ajax98/permamote/hardware/permamote/rev_b/permamote.brd

## EAGLE design hardware/permamote/rev_b/permamote.brd (2017-11-19)

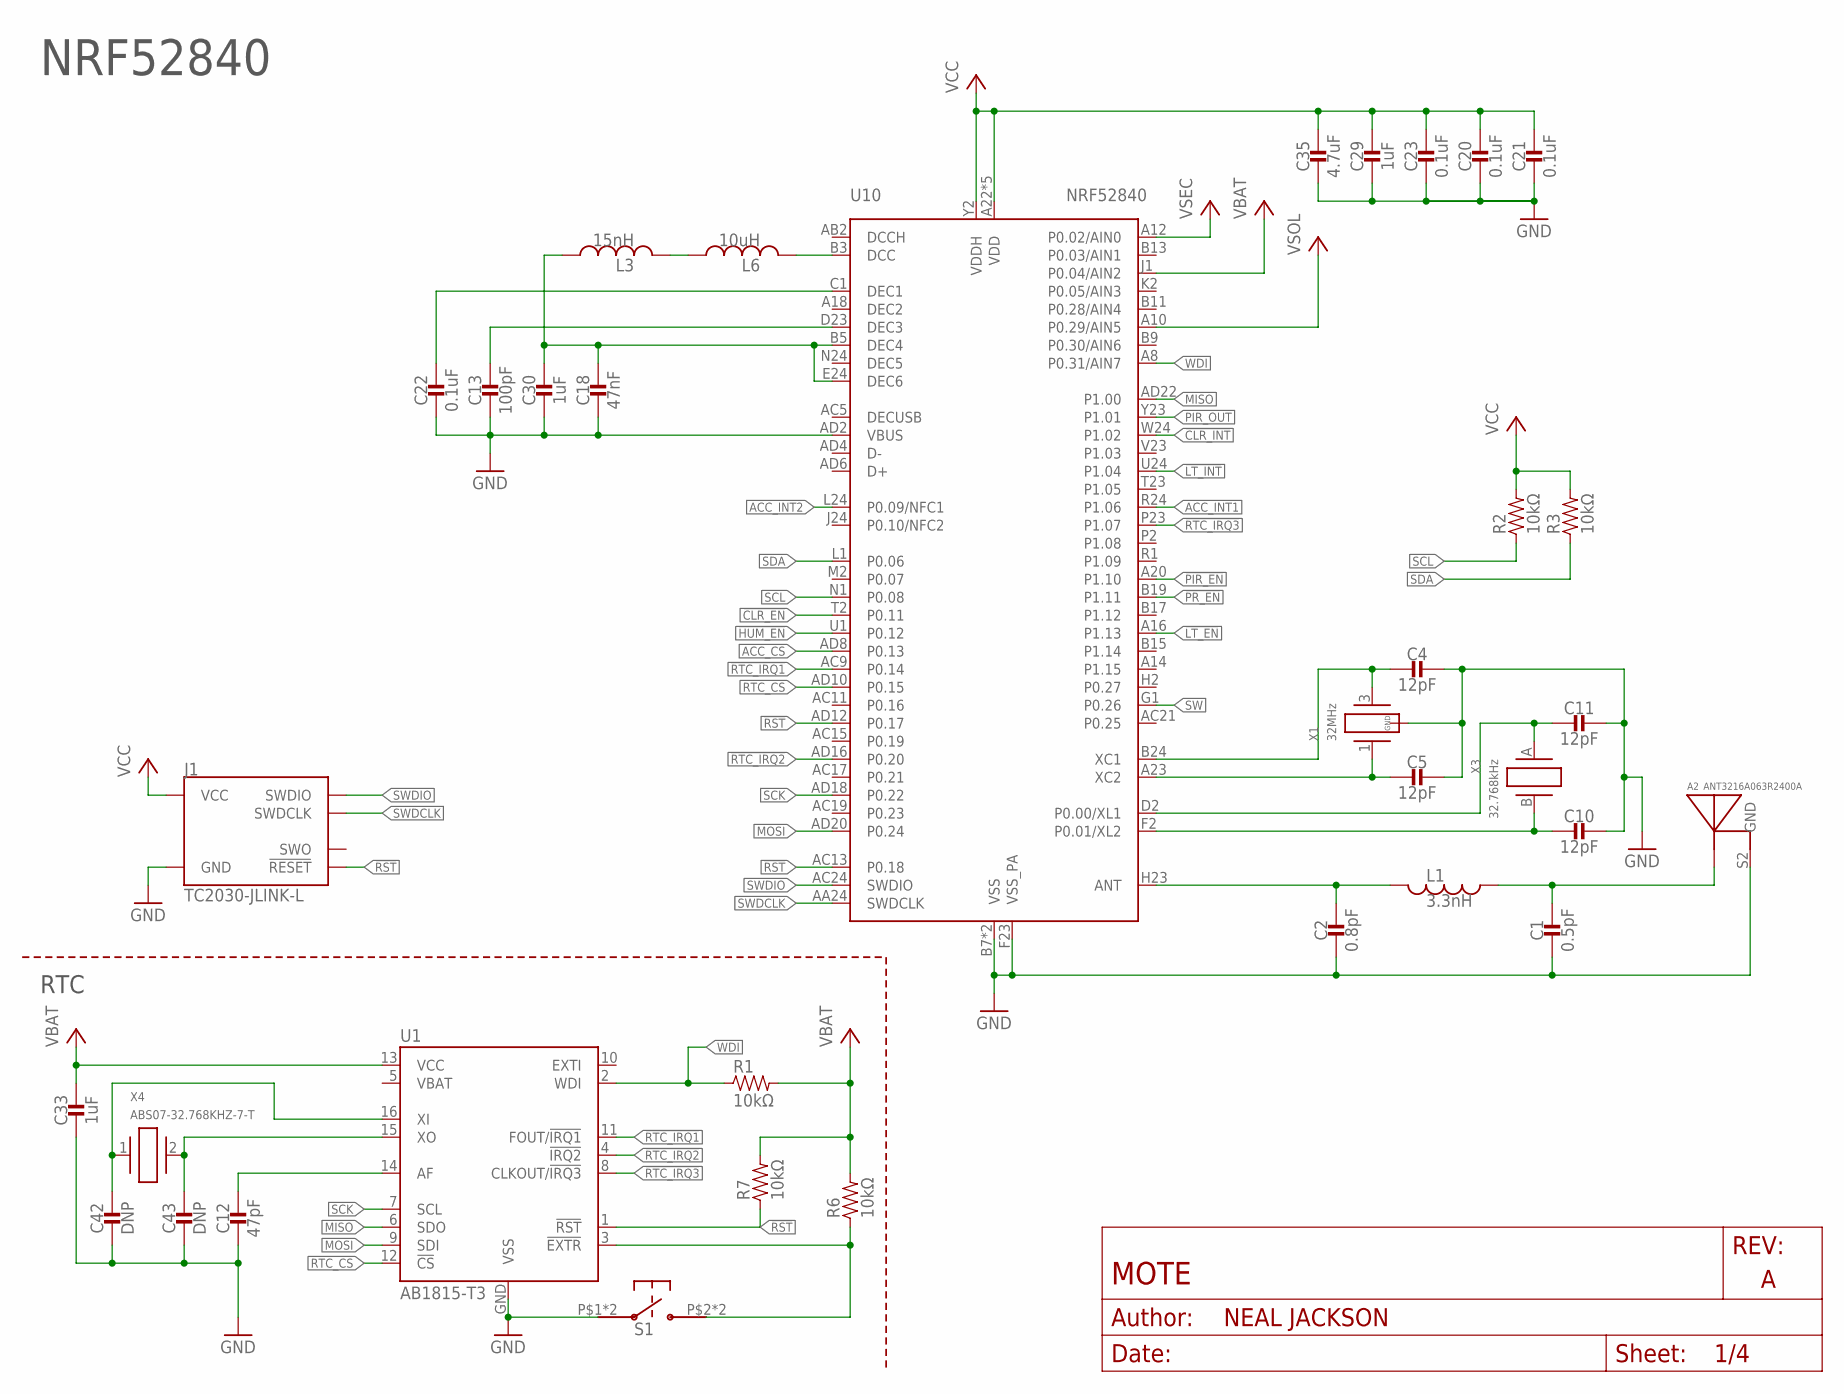
[picture p1: schematic permamote.sch, sheet 1]

Parts:
A2: ANT3216A063R2400A
C1: 0.5pF; 0402_CAP; DIGIKEY 490-6264-1-ND
C2: 0.8pF; 0402_CAP; DIGIKEY 490-6269-1-ND
C4, C5, C10, C11: 12pF; 0402_CAP; DIGIKEY 490-6197-1-ND
C12: 47pF; 0402_CAP; DIGIKEY 490-5942-1-ND
C13: 100pF; 0402_CAP; DIGIKEY 490-5922-1-ND
C18: 47nF; 0402_CAP; DIGIKEY 445-1264-1-ND
C20, C21, C22, C23: 0.1uF; 0402_CAP; DIGIKEY 490-6328-1-ND
C29, C30, C33: 1uF; 0402_CAP; DIGIKEY 490-7195-1-ND
C35: 4.7uF; 0402_CAP; DIGIKEY 445-5947-1-ND
C42, C43: DNP; 0402_CAP
J1: TC2030-JLINK-L; TC2030-IDC
L1: 3.3nH; 0402_CAP; DIGIKEY 535-10426-1-ND
L3: 15nH; 0402_CAP; DIGIKEY 587-1521-1-ND
L6: 10uH; 0603_CAP; DIGIKEY 490-4025-1-ND
R1, R2, R3, R6, R7: 10kΩ; 0402_RES; DIGIKEY 311-10KJRCT-ND
S1: EVQP2
U1: AB1815-T3; QFN-16-3MM
U10: NRF52840; AQFN73
X1: 32MHz; TXC-7V
X3: 32.768kHz; ABS05
X4: ABS07-32.768KHZ-7-T; 2-SMD

Connections:
!CLR_EN: U10.T2 (P0.11); also elsewhere on the board
!CLR_INT: U10.W24 (P1.02); also elsewhere on the board
!HUM_EN: U10.U1 (P0.12); also elsewhere on the board
!LT_EN: U10.A16 (P1.13); also elsewhere on the board
!LT_INT: U10.U24 (P1.04); also elsewhere on the board
!PIR_EN: U10.A20 (P1.10); also elsewhere on the board
!PR_EN: U10.B19 (P1.11); also elsewhere on the board
!RST: J1.3 (!RESET), R7.1, U1.1 (!RST), U10.AC13 (P0.18), U10.AD12 (P0.17); also elsewhere on the board
!RTC_EXTR: R6.1, S1.P$2, S1.P$4, U1.3 (!EXTR)
!RTC_IRQ1: U1.11 (FOUT/!IRQ1), U10.AC9 (P0.14); also elsewhere on the board
!RTC_IRQ2: U1.4 (!IRQ2), U10.AD16 (P0.20); also elsewhere on the board
!RTC_IRQ3: U1.8 (CLKOUT/!IRQ3), U10.P23 (P1.07); also elsewhere on the board
ACC_CS: U10.AD8 (P0.13); also elsewhere on the board
ACC_INT1: U10.R24 (P1.06); also elsewhere on the board
ACC_INT2: U10.L24 (P0.09/NFC1); also elsewhere on the board
GND: A2.S2 (GND), C1.2, C2.2, C4.1, C5.1, C10.1, C11.1, C12.2, C13.2, C18.2, C20.2, C21.2, C22.2, C23.2, C29.2, C30.2, C33.2, C35.2, C42.2, C43.2, J1.5 (GND), S1.P$1, S1.P$3, U1.GND (VSS), U10.AD2 (VBUS), U10.B7 (VSS), U10.F23 (VSS_PA), U10.GND (VSS), X1.2 (GND), X1.4 (GND); also elsewhere on the board
MISO: U1.6 (SDO), U10.AD22 (P1.00); also elsewhere on the board
MOSI: U1.9 (SDI), U10.AD20 (P0.24); also elsewhere on the board
unnamed: C22.1, U10.C1 (DEC1)
unnamed: C18.1, C30.1, L3.1, U10.B5 (DEC4), U10.E24 (DEC6)
unnamed: C13.1, U10.D23 (DEC3)
unnamed: C2.1, L1.2, U10.H23 (ANT)
unnamed: A2.S1 (ANTENNA), C1.1, L1.1
unnamed: C4.2, U10.B24 (XC1), X1.3 (2)
unnamed: C5.2, U10.A23 (XC2), X1.1
unnamed: C12.1, U1.14 (AF)
unnamed: C42.1, U1.16 (XI), X4.1
unnamed: C43.1, U1.15 (XO), X4.2
unnamed: L6.2, U10.B3 (DCC)
unnamed: L3.2, L6.1
PIR_OUT: U10.Y23 (P1.01); also elsewhere on the board
RTC_CS: U1.12 (!CS), U10.AD10 (P0.15); also elsewhere on the board
SCK: U1.7 (SCL), U10.AD18 (P0.22); also elsewhere on the board
SCL: R2.1, U10.N1 (P0.08); also elsewhere on the board
SDA: R3.1, U10.L1 (P0.06); also elsewhere on the board
SW: U10.G1 (P0.26); also elsewhere on the board
SWDCLK: J1.4 (SWDCLK), U10.AA24 (SWDCLK)
SWDIO: J1.2 (SWDIO), U10.AC24 (SWDIO)
VBAT: C33.1, R1.2, R6.2, R7.2, U1.13 (VCC), U10.J1 (P0.04/AIN2); also elsewhere on the board
VCC: C20.1, C21.1, C23.1, C29.1, C35.1, J1.1 (VCC), R2.2, R3.2, U10.A22 (VDD), U10.AD14 (VDD), U10.AD23 (VDD), U10.B1 (VDD), U10.W1 (VDD), U10.Y2 (VDDH); also elsewhere on the board
VSEC: U10.A12 (P0.02/AIN0); also elsewhere on the board
VSOL: U10.A10 (P0.29/AIN5); also elsewhere on the board
WDI: R1.1, U1.2 (WDI), U10.A8 (P0.31/AIN7); also elsewhere on the board
XL1: C11.2, U10.D2 (P0.00/XL1), X3.A (1)
XL2: C10.2, U10.F2 (P0.01/XL2), X3.B (2)

Notes on the sheet:
NRF52840
RTC

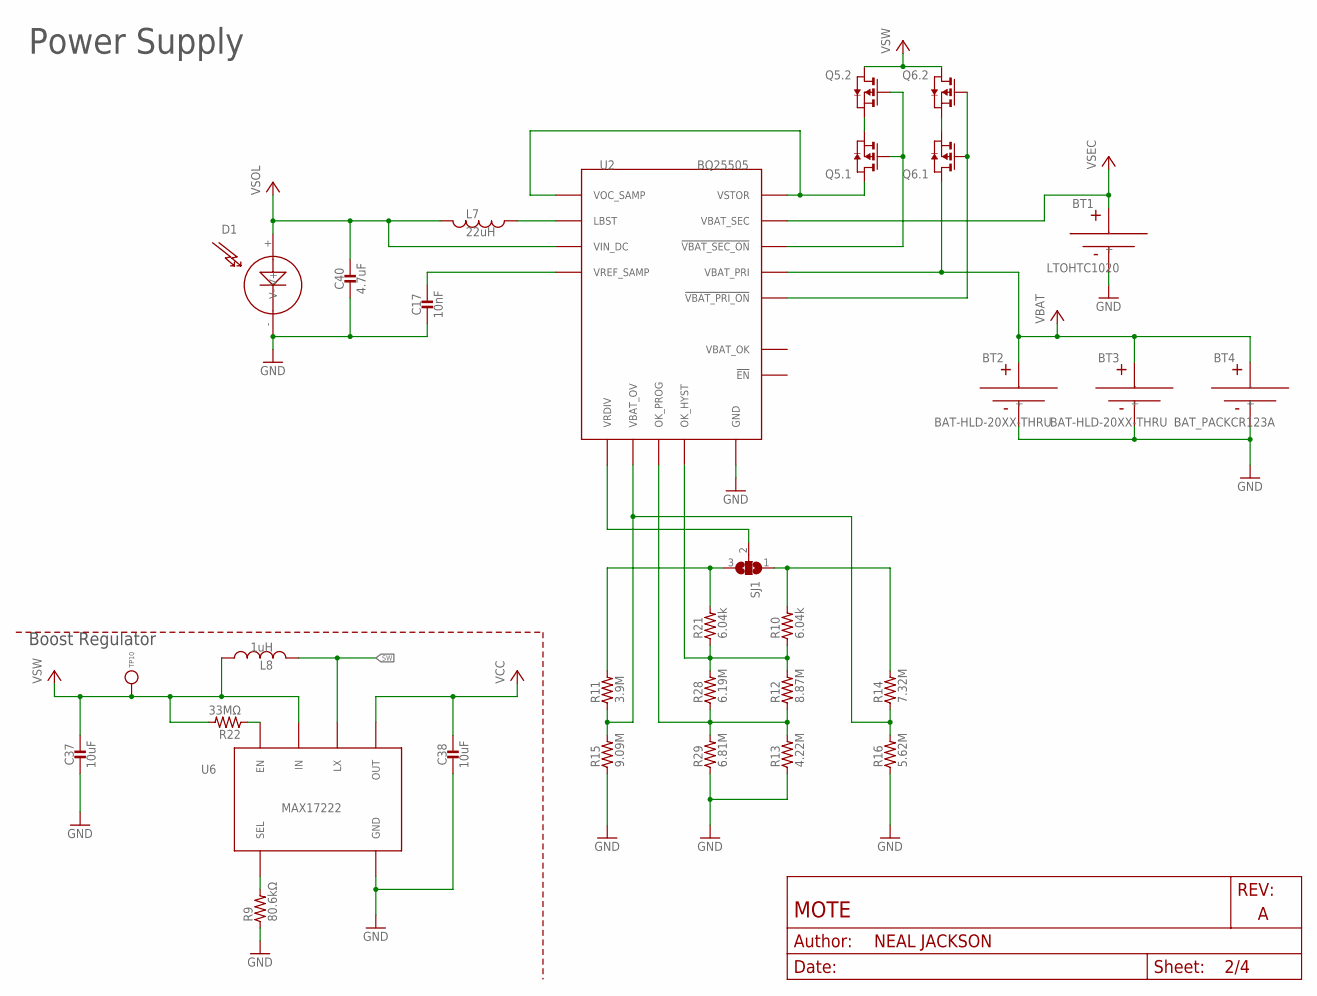
[picture p2: schematic permamote.sch, sheet 2]

Parts:
BT1: LTOHTC1020; 1020
BT2, BT3: BAT-HLD-20XX-THRU
BT4: BAT_PACKCR123A; BH123A
C17: 10nF; 0603_CAP; DIGIKEY 490-4516-1-ND
C37, C38: 10uF; 0603_CAP; DIGIKEY 490-3896-1-ND
C40: 4.7uF; 0603_CAP; DIGIKEY 490-3896-1-ND
D1: SOLARCELL; SOLAR_HOLES
L7: 22uH; 74437324220; DIGIKEY 732-3340-1-ND
L8: 1uH; IHL-1212BZ-11; MPN IHLP1212BZER1R0M11; DIGIKEY 541-1319-1-ND
Q5, Q6: PMDXB950UPEL; XDFN-6
R9: 80.6kΩ; 0603-RES; DIGIKEY 311-80.6KHRCT-ND
R10, R21: 6.04k; 0402_RES; DIGIKEY YAG3306CT-ND
R11: 3.9M; 0402_RES; DIGIKEY YAG3306CT-ND
R12: 8.87M; 0402_RES; DIGIKEY YAG3306CT-ND
R13: 4.22M; 0402_RES; DIGIKEY YAG3306CT-ND
R14: 7.32M; 0402_RES; DIGIKEY YAG3306CT-ND
R15: 9.09M; 0402_RES; DIGIKEY YAG3306CT-ND
R16: 5.62M; 0402_RES; DIGIKEY YAG3306CT-ND
R22: 33MΩ; 0603-RES; DIGIKEY HMC0603JT33M0CT-ND
R28: 6.19M; 0402_RES; DIGIKEY YAG3306CT-ND
R29: 6.81M; 0402_RES; DIGIKEY YAG3306CT-ND
SJ1: SJ2W; SJ_2
TP10: TEST_POINT_0.040IN; TESTPOINT_0.040IN
U2: BQ25505; S-PVQFN-N20-RGR
U6: MAX17222; UDFN-6-MAXIM

Connections:
GND: BT1.-, BT2.GND (-), BT3.GND (-), BT4.-, C17.2, C37.2, C38.2, C40.2, D1.- (V-), R9.1, R13.1, R15.1, R16.1, R29.1, U2.1 (GND), U2.6 (GND), U2.15 (GND), U2.16 (GND), U2.17 (GND), U2.PAD (GND), U6.3 (GND); also elsewhere on the board
unnamed: R11.2, R21.2, SJ1.3
unnamed: R9.2, U6.4 (SEL)
unnamed: R22.1, U6.6 (EN)
unnamed: R10.2, R14.2, SJ1.1
unnamed: R11.1, R14.1, R15.2, R16.2, U2.7 (VBAT_OV)
unnamed: C17.1, U2.4 (VREF_SAMP)
unnamed: SJ1.2, U2.8 (VRDIV)
unnamed: L7.P$1 (1), U2.20 (LBST)
unnamed: Q5.1 (S), Q5.4 (S)
unnamed: Q5.2 (G), Q5.5 (G), U2.9 (!VBAT_SEC_ON)
unnamed: Q5.6 (D), U2.3 (VOC_SAMP), U2.19 (VSTOR)
unnamed: Q6.1 (S), Q6.4 (S)
unnamed: Q6.2 (G), Q6.5 (G), U2.10 (!VBAT_PRI_ON)
unnamed: R12.1, R13.2, R28.1, R29.2, U2.12 (OK_PROG)
unnamed: R10.1, R12.2, R21.1, R28.2, U2.11 (OK_HYST)
SW: L8.P$2 (2), U6.2 (LX); also elsewhere on the board
VBAT: BT2.+1 (+), BT2.+2 (+), BT2.+3 (+), BT2.+4 (+), BT3.+1 (+), BT3.+2 (+), BT3.+3 (+), BT3.+4 (+), BT4.+, Q6.6 (D), U2.14 (VBAT_PRI); also elsewhere on the board
VCC: C38.1, U6.1 (OUT); also elsewhere on the board
VSEC: BT1.+, U2.18 (VBAT_SEC); also elsewhere on the board
VSOL: C40.1, D1.+ (V+), L7.P$2 (2), U2.2 (VIN_DC); also elsewhere on the board
VSW: C37.1, L8.P$1 (1), Q5.3 (D), Q6.3 (D), R22.2, TP10.TESTPOINT, U6.5 (IN)

Notes on the sheet:
Power Supply
Boost Regulator

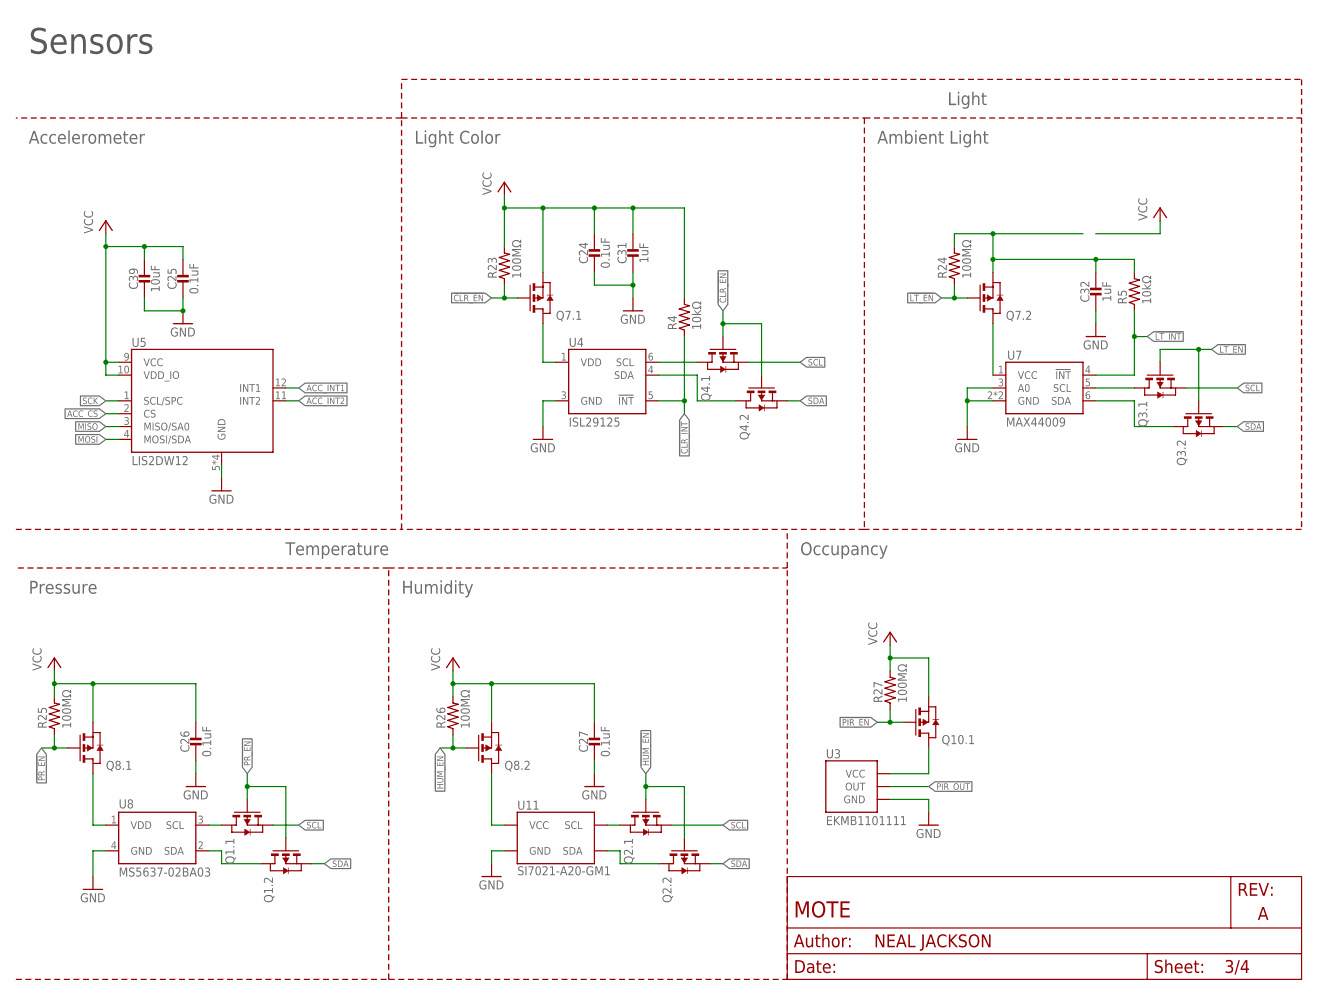
[picture p3: schematic permamote.sch, sheet 3]

Parts:
C24, C25, C26, C27: 0.1uF; 0402_CAP; DIGIKEY 490-6328-1-ND
C31, C32: 1uF; 0402_CAP; DIGIKEY 490-7195-1-ND
C39: 10uF; 0603_CAP; DIGIKEY 490-3896-1-ND
Q1, Q2, Q3, Q4, Q7, Q8, Q10: PMDXB950UPEL; XDFN-6
R4, R5: 10kΩ; 0402_RES; DIGIKEY 311-10KJRCT-ND
R23, R24, R25, R26, R27: 100MΩ; 0402_RES; DIGIKEY 541-100MAHCT-ND
U3: EKMB1101111; AMN2
U4: ISL29125; ODFN-6-1.5MMX1.6MM
U5: LIS2DW12; LGA-12
U7: MAX44009; UDFN-6-EXPOSED
U8: MS5637-02BA03; 4-SMD
U11: SI7021-A20-GM1; DFN-6/3MM

Connections:
!CLR_EN: Q4.2 (G), Q4.5 (G), Q7.2 (G), R23.1; also elsewhere on the board
!CLR_INT: R4.1, U4.5 (!INT); also elsewhere on the board
!HUM_EN: Q2.2 (G), Q2.5 (G), Q8.5 (G), R26.1; also elsewhere on the board
!LT_EN: Q3.2 (G), Q3.5 (G), Q7.5 (G), R24.1; also elsewhere on the board
!LT_INT: R5.1, U7.4 (!INT); also elsewhere on the board
!PIR_EN: Q10.2 (G), R27.1; also elsewhere on the board
!PR_EN: Q1.2 (G), Q1.5 (G), Q8.2 (G), R25.1; also elsewhere on the board
ACC_CS: U5.2 (CS); also elsewhere on the board
ACC_INT1: U5.12 (INT1); also elsewhere on the board
ACC_INT2: U5.11 (INT2); also elsewhere on the board
GND: C24.2, C25.2, C26.2, C27.2, C31.2, C32.2, C39.2, U3.GND, U4.3 (GND), U5.5 (GND), U5.6 (GND), U5.7 (GND), U5.8 (GND), U7.2 (GND), U7.3 (A0), U7.EP (GND), U8.4 (GND), U11.2 (GND); also elsewhere on the board
MISO: U5.3 (MISO/SA0); also elsewhere on the board
MOSI: U5.4 (MOSI/SDA); also elsewhere on the board
unnamed: Q7.3 (D), U7.1 (VCC)
unnamed: Q8.6 (D), U8.1 (VDD)
unnamed: Q8.3 (D), U11.5 (VCC)
unnamed: Q10.6 (D), U3.VCC
unnamed: Q7.6 (D), U4.1 (VDD)
unnamed: Q1.6 (D), U8.3 (SCL)
unnamed: C32.1, Q7.4 (S), R5.2, R24.2
unnamed: Q1.3 (D), U8.2 (SDA)
unnamed: Q2.3 (D), U11.1 (SDA)
unnamed: Q2.6 (D), U11.6 (SCL)
unnamed: Q3.3 (D), U7.6 (SDA)
unnamed: Q3.6 (D), U7.5 (SCL)
unnamed: Q4.3 (D), U4.4 (SDA)
unnamed: Q4.6 (D), U4.6 (SCL)
PIR_OUT: U3.OUT; also elsewhere on the board
SCK: U5.1 (SCL/SPC); also elsewhere on the board
SCL: Q1.1 (S), Q2.1 (S), Q3.1 (S), Q4.1 (S); also elsewhere on the board
SDA: Q1.4 (S), Q2.4 (S), Q3.4 (S), Q4.4 (S); also elsewhere on the board
VCC: C24.1, C25.1, C26.1, C27.1, C31.1, C39.1, Q7.1 (S), Q8.1 (S), Q8.4 (S), Q10.1 (S), R4.2, R23.2, R25.2, R26.2, R27.2, U5.9 (VCC), U5.10 (VDD_IO); also elsewhere on the board

Notes on the sheet:
Sensors
Accelerometer
Temperature
Humidity
Pressure
Ambient Light
Light Color
Light
Occupancy

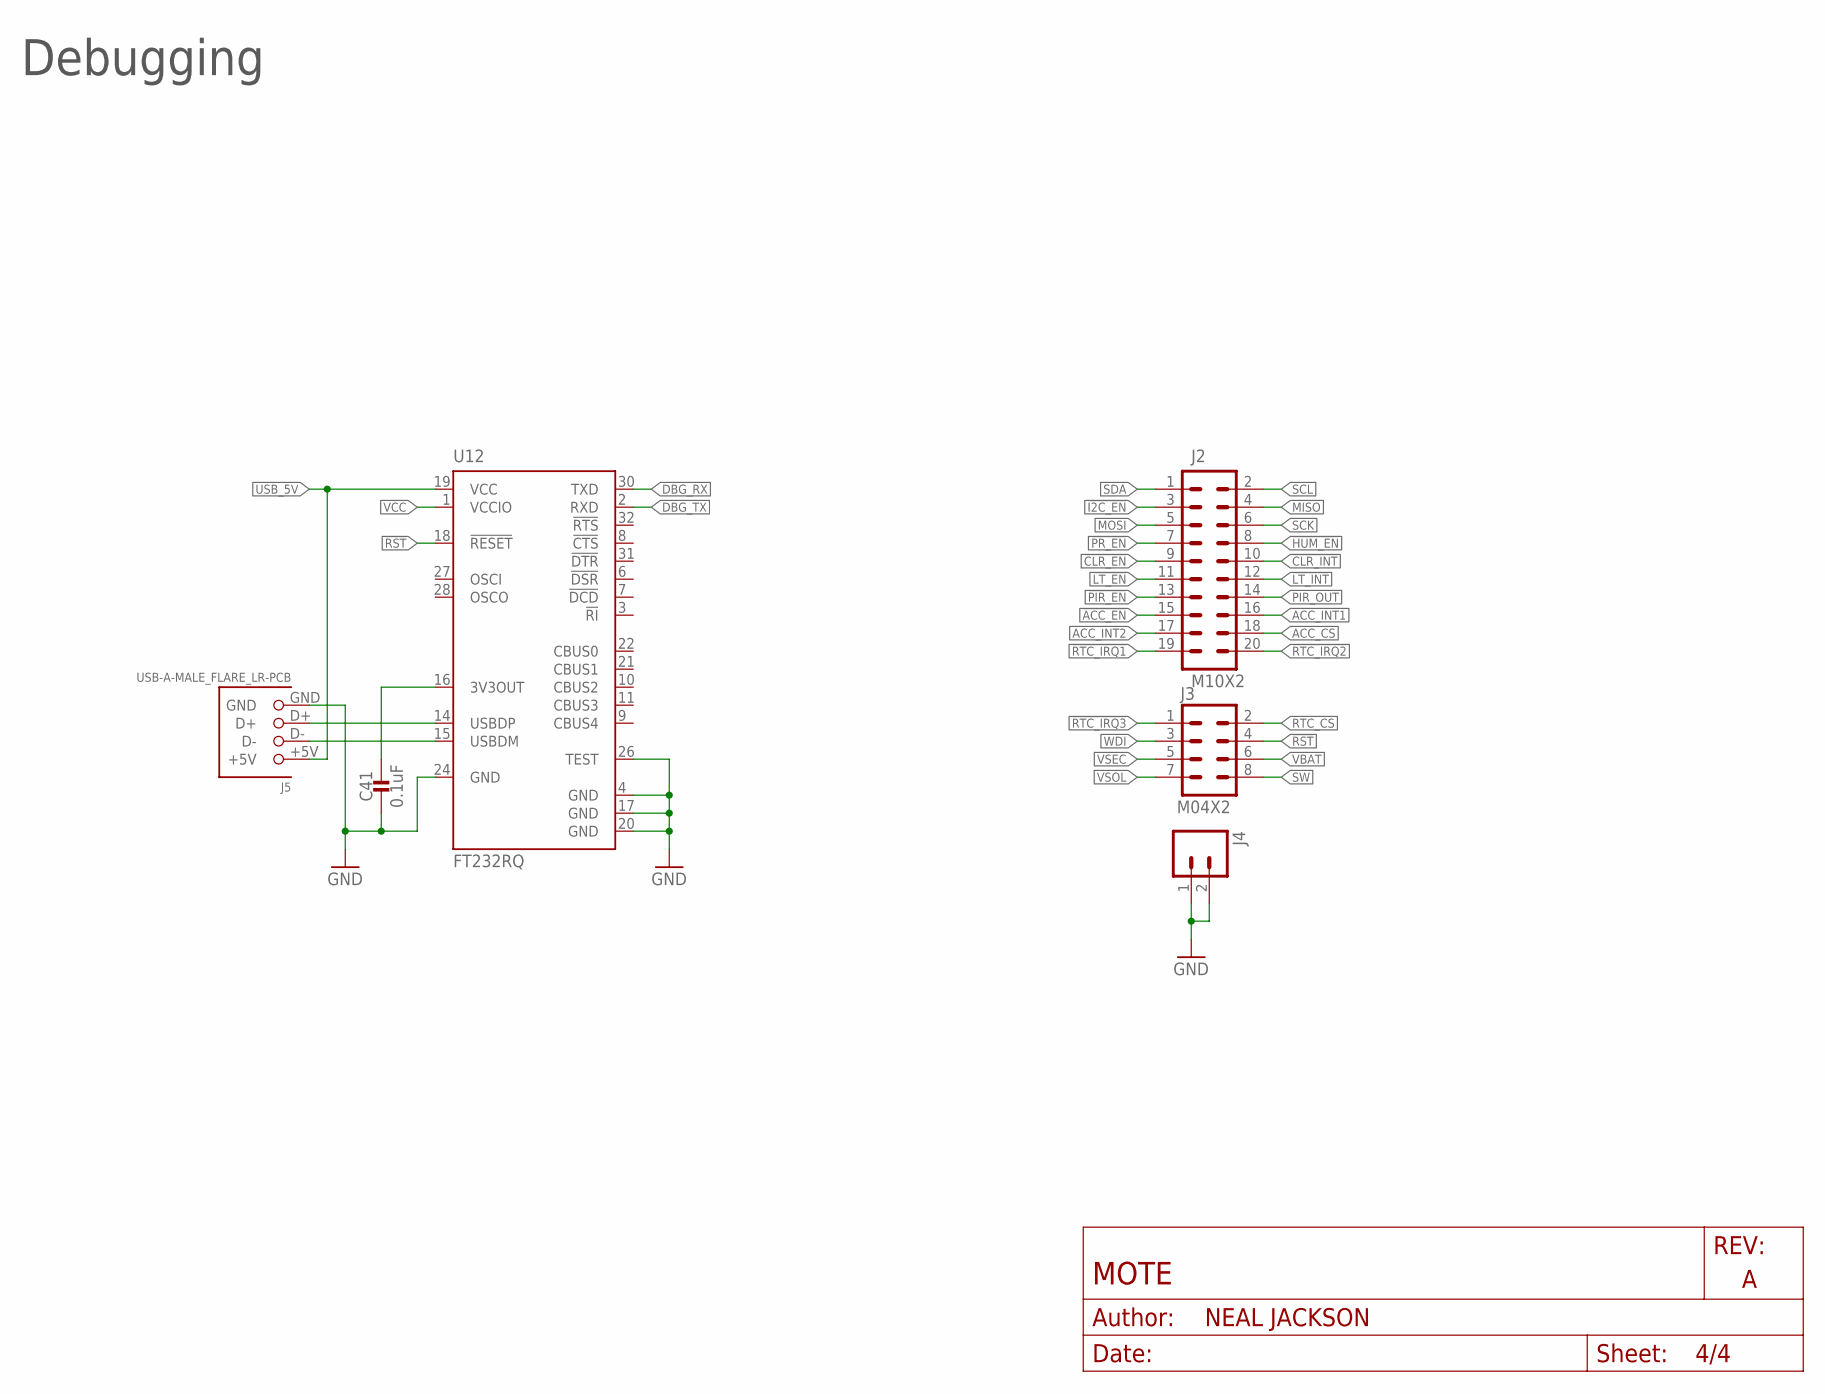
[picture p4: schematic permamote.sch, sheet 4]

Parts:
C41: 0.1uF; 0402_CAP; DIGIKEY 490-6328-1-ND
J2: M10X2; 2X10
J3: M04X2; 2X4
J4: M02PTH; 1X02
J5: USB-A-MALE_FLARE_LR-PCB; USB-A-MALE_FLARE_LR
U12: FT232RQ; QFN32

Connections:
!ACC_EN: J2.15
!CLR_EN: J2.9; also elsewhere on the board
!CLR_INT: J2.10; also elsewhere on the board
!HUM_EN: J2.8; also elsewhere on the board
!I2C_EN: J2.3
!LT_EN: J2.11; also elsewhere on the board
!LT_INT: J2.12; also elsewhere on the board
!PIR_EN: J2.13; also elsewhere on the board
!PR_EN: J2.7; also elsewhere on the board
!RST: J3.4, U12.18 (!RESET); also elsewhere on the board
!RTC_IRQ1: J2.19; also elsewhere on the board
!RTC_IRQ2: J2.20; also elsewhere on the board
!RTC_IRQ3: J3.1; also elsewhere on the board
ACC_CS: J2.18; also elsewhere on the board
ACC_INT1: J2.16; also elsewhere on the board
ACC_INT2: J2.17; also elsewhere on the board
DBG_RX: U12.30 (TXD)
DBG_TX: U12.2 (RXD)
GND: C41.2, J4.1, J4.2, J5.GND, U12.4 (GND), U12.17 (GND), U12.20 (GND), U12.24 (GND), U12.26 (TEST); also elsewhere on the board
MISO: J2.4; also elsewhere on the board
MOSI: J2.5; also elsewhere on the board
unnamed: C41.1, U12.16 (3V3OUT)
PIR_OUT: J2.14; also elsewhere on the board
RTC_CS: J3.2; also elsewhere on the board
SCK: J2.6; also elsewhere on the board
SCL: J2.2; also elsewhere on the board
SDA: J2.1; also elsewhere on the board
SW: J3.8; also elsewhere on the board
USB_5V: J5.+5V, U12.19 (VCC)
USB_D+: J5.D+, U12.14 (USBDP)
USB_D-: J5.D-, U12.15 (USBDM)
VBAT: J3.6; also elsewhere on the board
VCC: U12.1 (VCCIO); also elsewhere on the board
VSEC: J3.5; also elsewhere on the board
VSOL: J3.7; also elsewhere on the board
WDI: J3.3; also elsewhere on the board

Notes on the sheet:
Debugging

Board: 4 copper layers, 98 parts (0 on the bottom side), 79 nets, no tracks yet.

Other parts of the board:
U$1: UCB_CAL_200MIL
