ajax98/permamote/software/include/permamote.h

#ifndef PERMAMOTE_H
#define PERMAMOTE_H

#ifndef DEVICE_NAME
#define DEVICE_NAME "PERMAMOTE"
#endif /*DEVICE_NAME*/

#include <stdint.h>

//#define PLATFORM_ID_BYTE 0x22

// Address is written here in flash if the ID command is used
//#define ADDRESS_FLASH_LOCATION 0x0003fff8

// DEFINES FOR NRF52840
#ifdef NRF52840

// I2C through headers
#define I2C_SCL     NRF_GPIO_PIN_MAP(0,8)
#define I2C_SDA     NRF_GPIO_PIN_MAP(0,6)

// SPI through headers
#define SPI_SCLK    NRF_GPIO_PIN_MAP(0,22)
#define SPI_MISO    NRF_GPIO_PIN_MAP(1,0)
#define SPI_MOSI    NRF_GPIO_PIN_MAP(0,24)

// Light Sensor
#define MAX44009_EN  NRF_GPIO_PIN_MAP(1,13)
#define MAX44009_INT NRF_GPIO_PIN_MAP(1,4)

// Color Sensor
#define ISL29125_EN  NRF_GPIO_PIN_MAP(0,11)
#define ISL29125_INT NRF_GPIO_PIN_MAP(1,2)

// Pressure sensor
#define MS5637_EN   NRF_GPIO_PIN_MAP(1,11)

//Humidity Sensor
#define SI7021_EN   NRF_GPIO_PIN_MAP(0,12)

// Accelerometer
#define LI2D_CS     NRF_GPIO_PIN_MAP(0,13)
#define LI2D_INT1   NRF_GPIO_PIN_MAP(1,6)
#define LI2D_INT2   NRF_GPIO_PIN_MAP(0,9)

//PIR
#define PIR_EN      NRF_GPIO_PIN_MAP(1,10)
#define PIR_OUT     NRF_GPIO_PIN_MAP(1,1)

//RTC
#define RTC_CS      NRF_GPIO_PIN_MAP(0,15)
#define RTC_INT1    NRF_GPIO_PIN_MAP(0,14)
#define RTC_INT2    NRF_GPIO_PIN_MAP(0,20)
#define RTC_INT3    NRF_GPIO_PIN_MAP(1,10)
#define RTC_WDI     NRF_GPIO_PIN_MAP(0,31)

//ICOUNT
#define SWITCH      NRF_GPIO_PIN_MAP(0,26)

//BATTERIES
#define VSOL        NRF_GPIO_PIN_MAP(0,29)
#define VPRIMARY    NRF_GPIO_PIN_MAP(0,4)
#define VSECONDARY  NRF_GPIO_PIN_MAP(0,2)

// DEFINES FOR NRF51822
#elif defined(NRF51822)

// I2C through headers
#define I2C_SCL     10
#define I2C_SDA     8

// SPI through headers
#define SPI_SCLK    13
#define SPI_MISO    11
#define SPI_MOSI    12

// Light Sensor
#define MAX44009_EN  18
#define MAX44009_INT 28

// Color Sensor
#define ISL29125_EN  17
#define ISL29125_INT 29

// Pressure sensor
#define MS5637_EN   20

//Humidity Sensor
#define SI7021_EN   15

// Accelerometer
#define LI2D_CS     14
#define LI2D_INT1   6
#define LI2D_INT2   7

//PIR
#define PIR_EN      19
#define PIR_OUT     30

//RTC
#define RTC_CS      22
#define RTC_INT1    25
#define RTC_INT2    24
#define RTC_INT3    23
#define RTC_WDI     21

//ICOUNT
#define SWITCH      4

//BATTERIES
#define VSOL        3
#define VPRIMARY    2
#define VSECONDARY  1

#endif //NRF51822
#endif
