ajax98/permamote/(commit log)

2017-11-19 WIP rev_b
    [permamote.brd, permamote.sch]
2017-11-19 fix check for NRF52840
    [permamote.h]
